rotorgarage/funhog/funhog/accessories/ass-paddle/ass-paddle.dxf.png

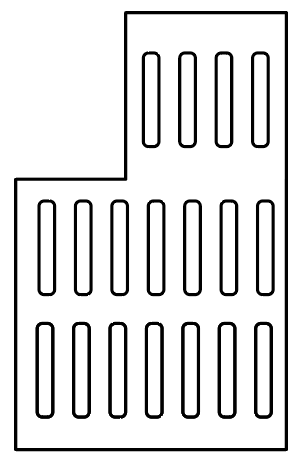
funhog/accessories/ass-paddle/ass-paddle.dxf.png
