rotorgarage/funhog/funhog/arms/2.5-inch-arm.dxf.png

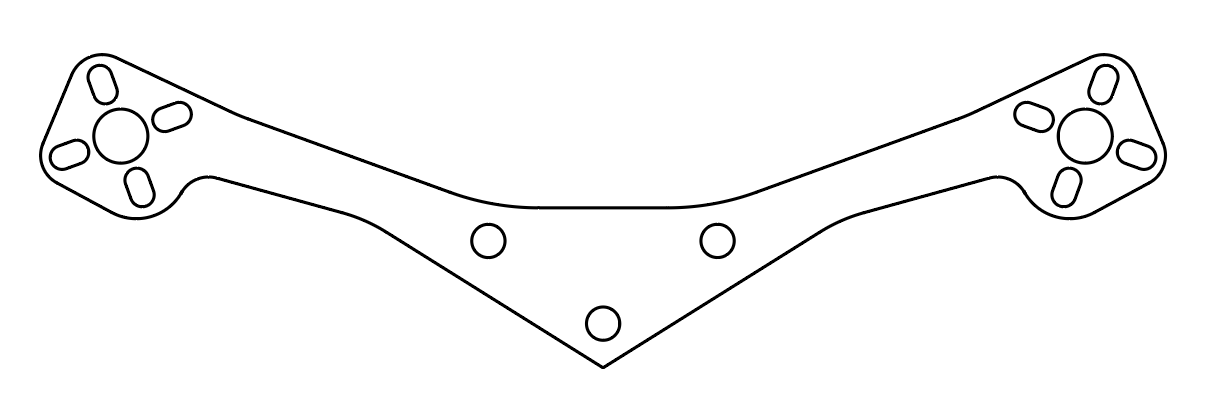
funhog/arms/2.5-inch-arm.dxf.png
