rotorgarage/funhog/funhog/arms/3-inch-arm.dxf.png

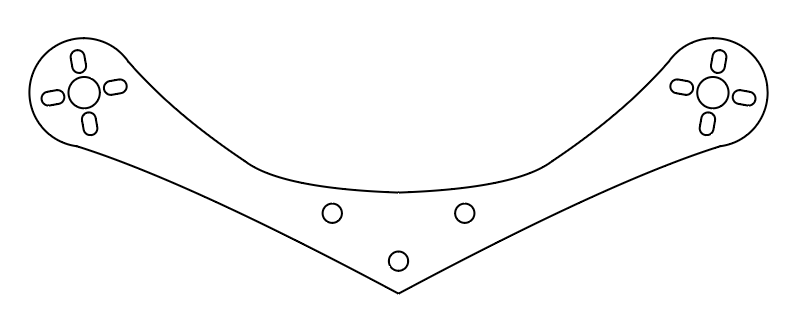
funhog/arms/3-inch-arm.dxf.png
