rotorgarage/funhog/funhog/arms/3in-arm-nubbies.dxf.png

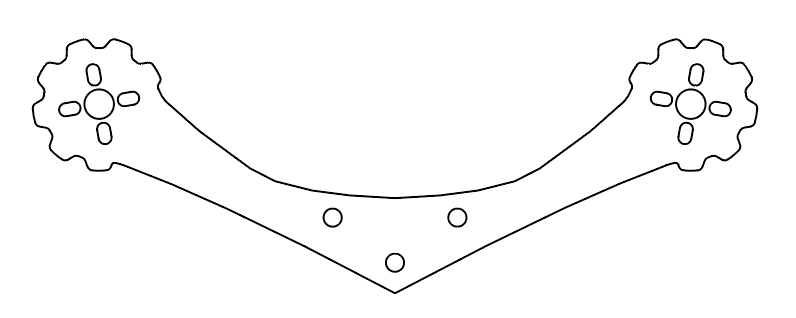
funhog/arms/3in-arm-nubbies.dxf.png
