rotorgarage/funhog/funhog/arms/4-inch-arm.dxf.png

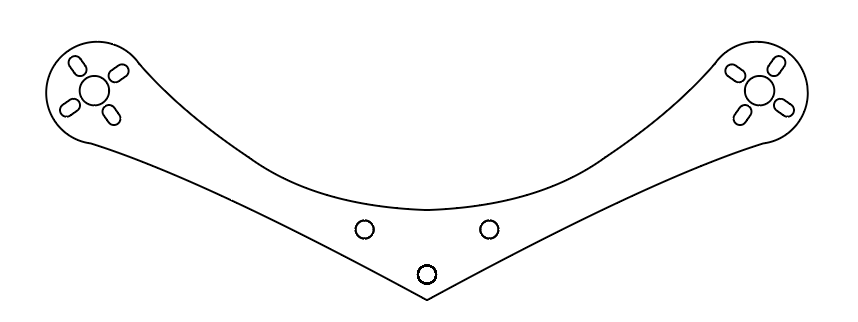
funhog/arms/4-inch-arm.dxf.png
