rotorgarage/funhog/funhog/plates/v3-top-[straps].dxf.png

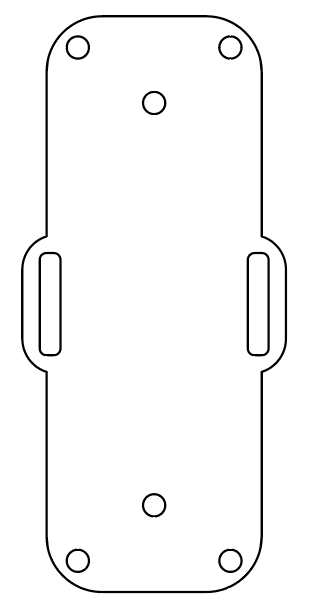
funhog/plates/v3-top-[straps].dxf.png
