rotorgarage/funhog/funhog/plates/v3-universal-base.dxf.png

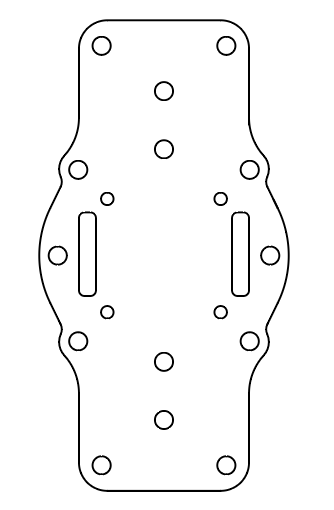
funhog/plates/v3-universal-base.dxf.png
