rotorgarage/funhog/naked-thumb/naked-thumb-v3-pair.dxf.png

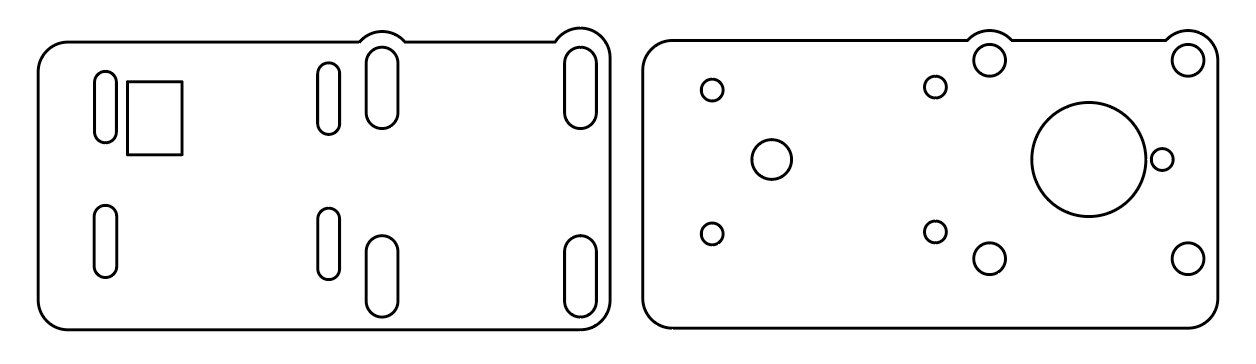
naked-thumb/naked-thumb-v3-pair.dxf.png
