rotorgarage/funhog/funhog/accessories/ass-paddle/ass-paddle.dxf

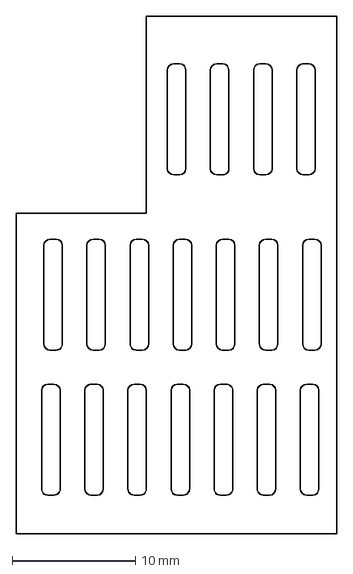
[picture p13: CAD file, 2023-03-05]
funhog/accessories/ass-paddle/ass-paddle.dxf
26.0 x 42.0 mm
