rotorgarage/funhog/funhog/accessories/camera-flap/25mm-camera-flaps.dxf

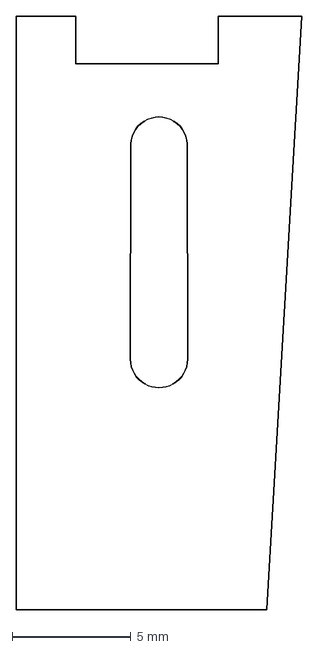
[picture p14: CAD file, 2023-03-05]
funhog/accessories/camera-flap/25mm-camera-flaps.dxf
12.0 x 25.0 mm
