rotorgarage/funhog/funhog/arms/3in-arm-nubbies.dxf

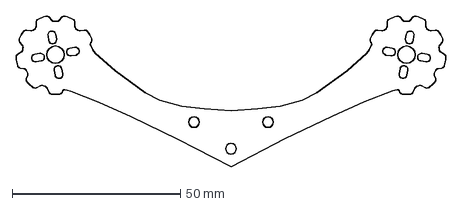
[picture p15: CAD file, 2023-03-08]
funhog/arms/3in-arm-nubbies.dxf
127.8 x 44.9 mm
