rotorgarage/funhog/funhog/plates/v3-top-[straps].dxf

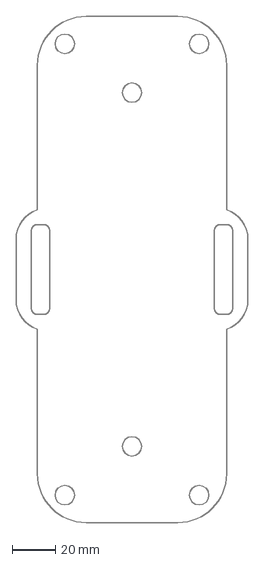
[picture p16: CAD file, 2023-03-05]
funhog/plates/v3-top-[straps].dxf
107.7 x 235.3 mm
