rotorgarage/funhog/naked-thumb/naked-thumb-v3-pair.dxf

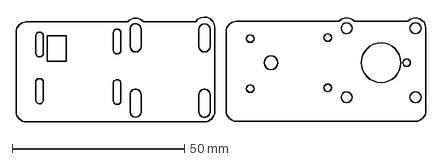
[picture p17: CAD file, 2023-03-05]
naked-thumb/naked-thumb-v3-pair.dxf
118.9 x 30.7 mm
