rotorgarage/funhog/funhog/accessories/camera-flap/20mm-camera-flap.dxf

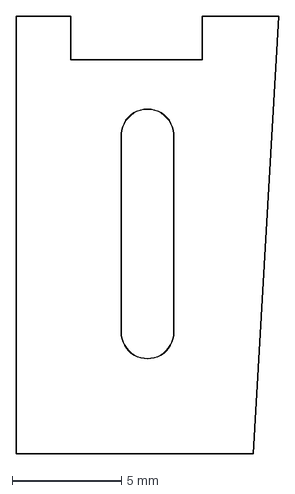
[picture p18: CAD file, 2023-03-05]
funhog/accessories/camera-flap/20mm-camera-flap.dxf
12.0 x 20.0 mm
