rotorgarage/funhog/funhog/arms/3-inch-arm.dxf

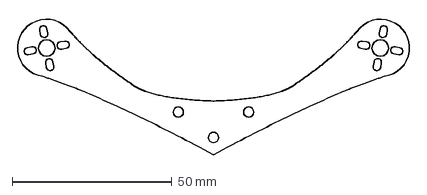
[picture p19: CAD file, 2023-03-05]
funhog/arms/3-inch-arm.dxf
123.4 x 43.3 mm
