rotorgarage/funhog/funhog/plates/v3-universal-base.dxf

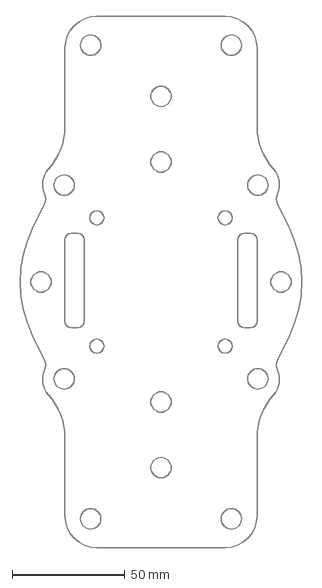
[picture p20: CAD file, 2023-03-05]
funhog/plates/v3-universal-base.dxf
128.4 x 235.3 mm
