rotorgarage/funhog/funhog/arms/4-inch-arm.dxf

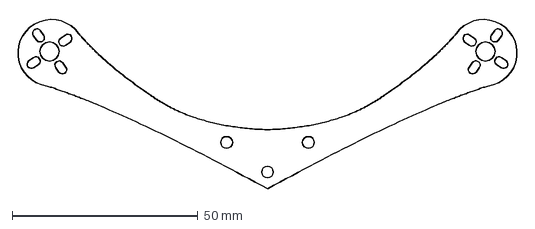
[picture p21: CAD file, 2023-03-05]
funhog/arms/4-inch-arm.dxf
135.2 x 46.5 mm
