rotorgarage/funhog/funhog/arms/2.5-inch-arm.dxf

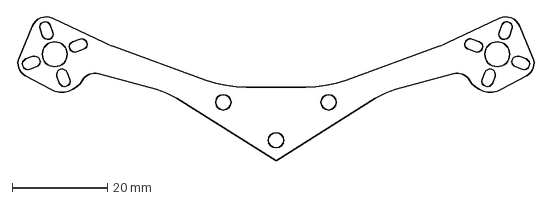
[picture p22: CAD file, 2023-03-05]
funhog/arms/2.5-inch-arm.dxf
108.8 x 30.2 mm
