rotorgarage/funhog/(commit log)

2023-03-05 more progress
    [2.5-inch-arm.dxf, 20mm-camera-flap.dxf, 25mm-camera-flaps.dxf, 3-inch-arm.dxf, 3in-arm-nubbies.dxf, 4-inch-arm.dxf, ass-paddle.dxf, naked-thumb-v3-pair.dxf]
2023-03-05 update 25mm flaps
    [25mm-camera-flaps.dxf]
2023-03-08 closed paths on 3”, remdme work
    [3in-arm-nubbies.dxf]
